IWILZ/Servo-Tester-Arduino/Servo Tester 1.1 PCB.jpg

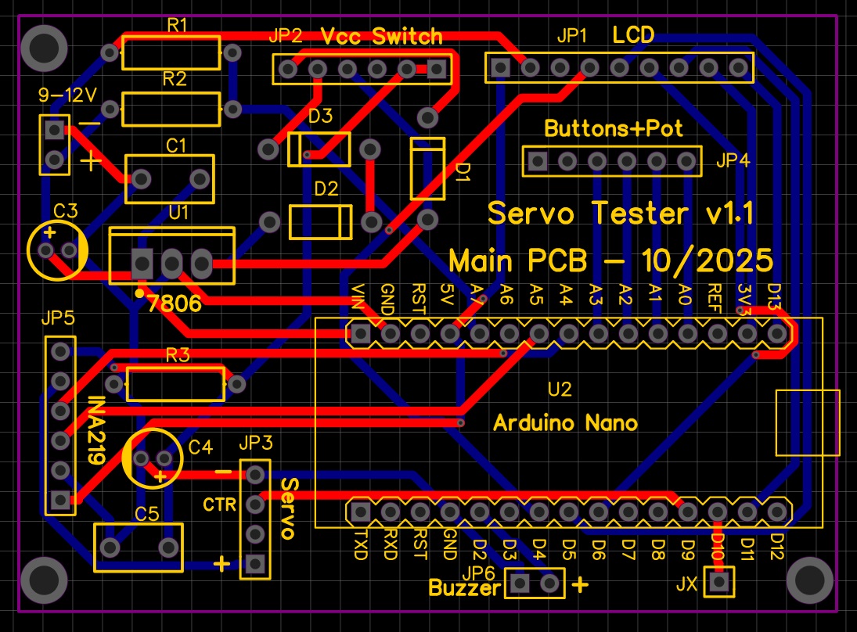
Servo Tester 1.1 PCB.jpg
