IWILZ/Servo-Tester-Arduino/Servo Tester 1.1 SCH.pdf

## GND

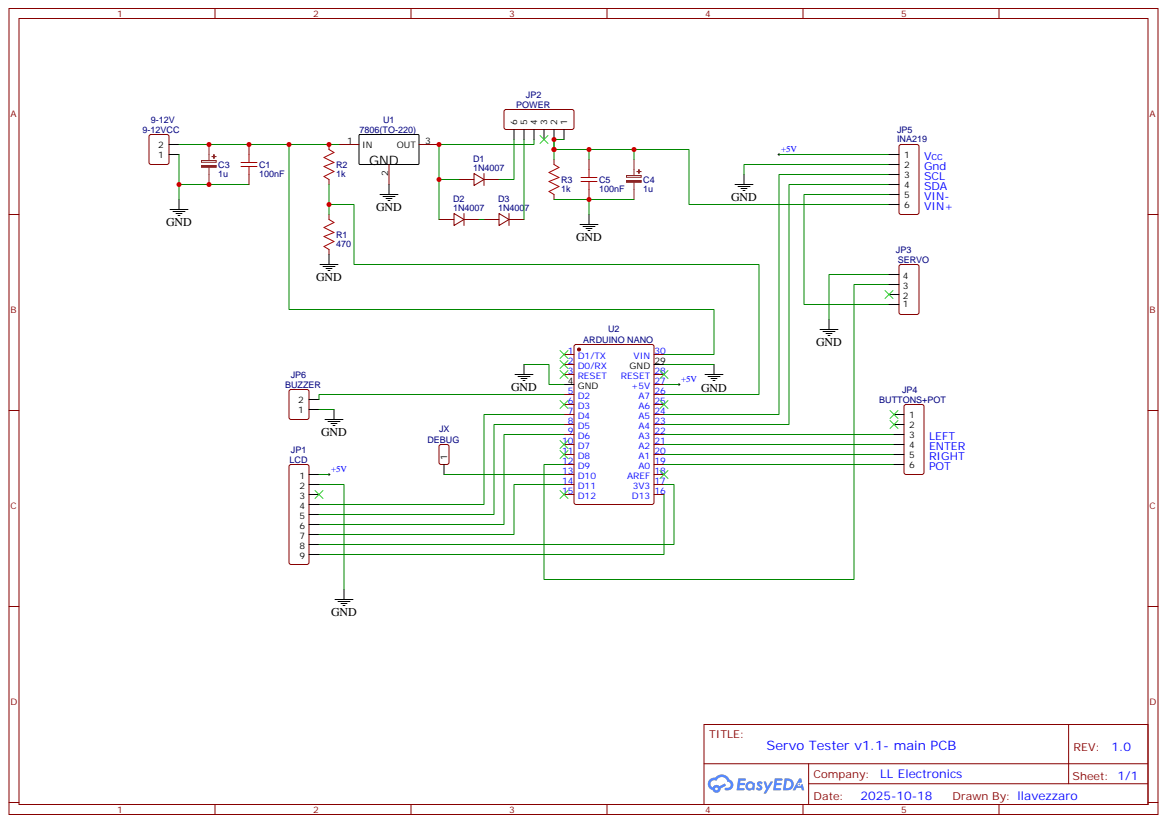
[picture p2: page 1]
