IWILZ/Servo-Tester-Arduino/Servo Tester 1.1 - LCD & Buttons PCB.jpg

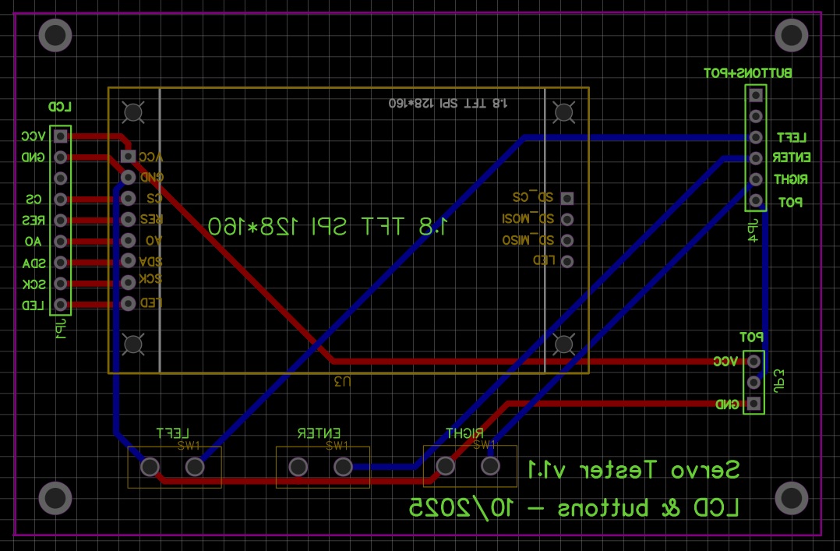
Servo Tester 1.1 - LCD & Buttons PCB.jpg
