IWILZ/Servo-Tester-Arduino/(commit log)

2025-10-23 Enhance README with project description
    Added project details for servo testing.
2025-10-23 Update README to indicate project is under construction
    Added a note about the project's current status.
2025-10-23 Add image to README for servo testing project
    Added an image to the README for better visualization.
2025-10-23 Update README with clearer servo operation details
    Clarified instructions for servo testing modes and power consumption.
2025-10-23 Enhance README with AUTO mode details and examples
    Clarify the purpose of AUTO mode and provide examples for power consumption comparisons.
2025-10-23 Improve README clarity on servo testing and power consumption
    Clarified the explanation of power consumption testing and servo performance comparison.
2025-10-23 Update README with clearer testing instructions
    Clarified instructions for on-board system test and power consumption calculations.
2025-10-23 Update README with schematic and component details
    Added details about additional components and PCB design.
2025-10-23 Clarify PCB design type in README
    Updated README to specify PCB design as 'standard'.
2025-10-23 Enhance README with voltage caution and component details
    Updated README to clarify voltage warning and component list.
2025-10-23 Improve README formatting and clarity
    Updated warning message formatting and clarified schematic description.
2025-10-24 Fix section title from 'PCBs' to 'PCB'
    Corrected the title from 'PCBs' to 'PCB' for consistency.
2025-10-24 Revise README for schematic and PCB details
    Updated section headers and added information about the secondary board.
2025-10-24 Add LiPo battery usage section to README
    Added section on using a LiPo battery for power supply, including recommendations for a step-up charger and a specific LiPo battery model.
2025-10-24 Update README with details on MIN_VIN and audio alarm
    Clarified the explanation regarding MIN_VIN and its relation to the Servo Tester audio alarm.
2025-10-24 Clarify power supply requirements for Servo Tester
    Updated the power supply section to specify a step-up charging module for the Servo Tester.
2025-10-24 Revise LiPo battery power supply section in README
    Updated the section on using a LiPo battery for power supply, adding links to recommended products.
2025-10-25 Fix wording about external power supply in README
    Corrected phrasing regarding external power supply in README.
2025-10-25 Update README with detailed test instructions
    Clarify testing procedures and safety precautions for on-board system tests.
2025-10-25 Clarify VEXT_DIV adjustment instructions
    Updated instructions for adjusting VEXT_DIV to clarify the connection method and ensure the voltage matches the tester.
2025-10-25 Revise LiPo battery power supply section title
    Updated section title and clarified power supply options.
2025-10-25 Fix typo in README regarding connector references
    Corrected a typo from 'cros' to 'cross' in the README.
2026-04-29 Added potentiometer value
    Corrected the value of the potentiometer to 5KΩ for clarity.
